grzechot/hex-screw-sorter/set_M3/ring_20mm_6.0.stl

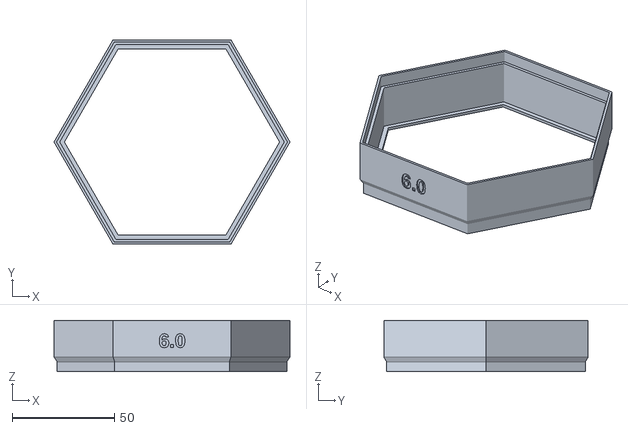
[picture p4: CAD file, 2026-10-30]
set_M3/ring_20mm_6.0.stl
115.5 x 100.0 x 25.0
