grzechot/hex-screw-sorter/set_M4/sieve_7.6.stl

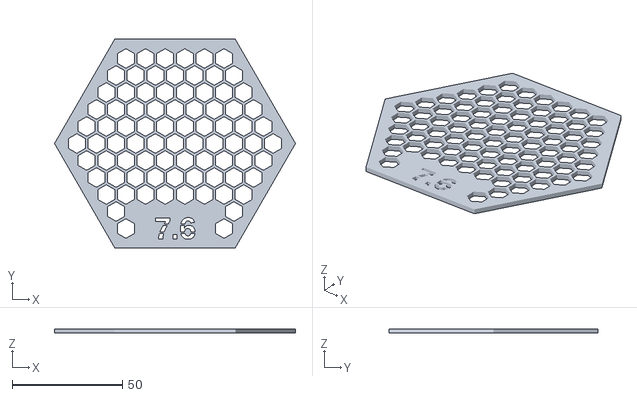
[picture p5: CAD file, 2026-10-30]
set_M4/sieve_7.6.stl
109.2 x 94.6 x 2.00
