grzechot/hex-screw-sorter/set_nuts/sieve_12.0.stl

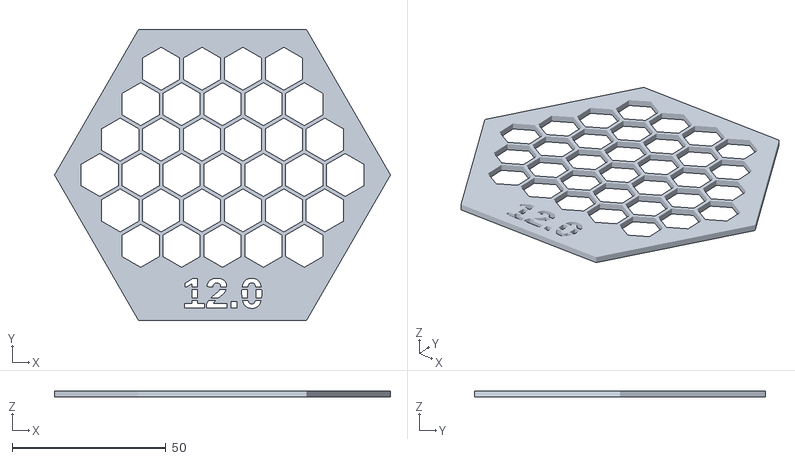
[picture p6: CAD file, 2026-10-30]
set_nuts/sieve_12.0.stl
109.2 x 94.6 x 2.00
