grzechot/hex-screw-sorter/set_M3/sieve_6.0.stl

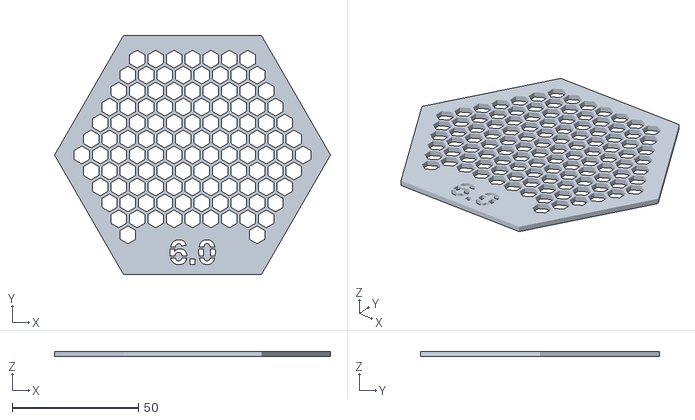
[picture p8: CAD file, 2026-10-30]
set_M3/sieve_6.0.stl
109.2 x 94.6 x 2.00
