grzechot/hex-screw-sorter/set_M4/sieve_4.3.stl

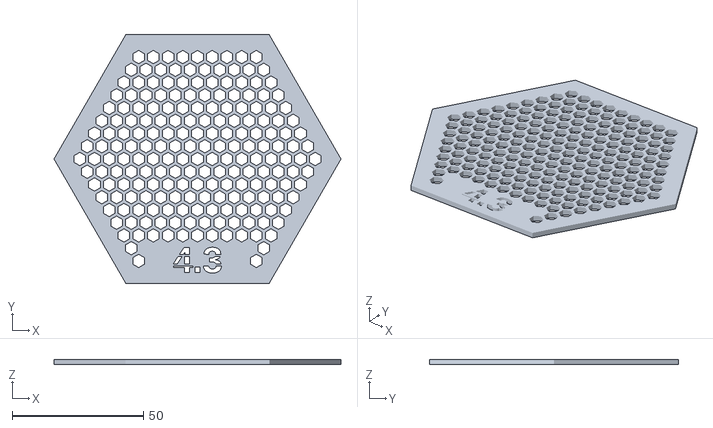
[picture p9: CAD file, 2026-10-30]
set_M4/sieve_4.3.stl
109.2 x 94.6 x 2.00
