grzechot/hex-screw-sorter/set_M3/lid.stl

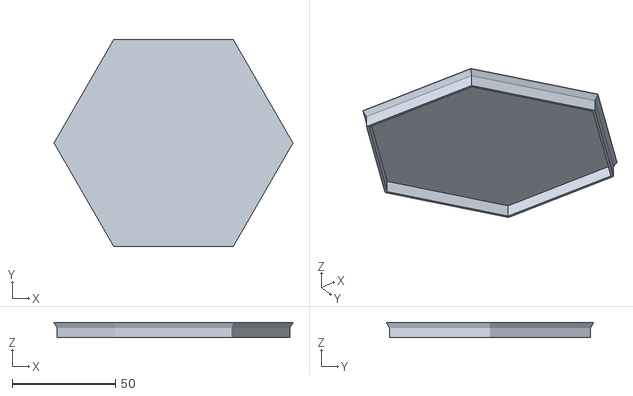
[picture p10: CAD file, 2026-10-30]
set_M3/lid.stl
115.5 x 100.0 x 7.40
