grzechot/hex-screw-sorter/set_M3/cup_20mm.stl

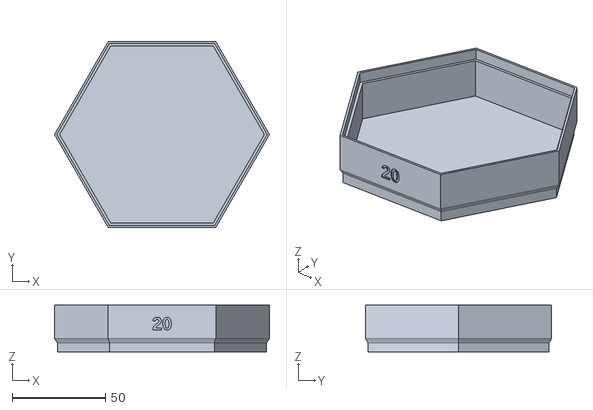
[picture p11: CAD file, 2026-10-30]
set_M3/cup_20mm.stl
115.5 x 100.0 x 25.0
