grzechot/hex-screw-sorter/(list of files, cad)

Other CAD files:
set_M3/ring_20mm_3.3.stl
set_M4/ring_20mm_4.3.stl
set_nuts/sieve_10.9.stl
set_M4/ring_20mm_7.6.stl
set_nuts/ring_20mm_8.7.stl
set_nuts/ring_20mm_13.1.stl
set_nuts/sieve_8.7.stl
set_nuts/sieve_13.1.stl
set_nuts/ring_20mm_12.0.stl
set_nuts/ring_20mm_10.9.stl
